w531t4/orangecrab-hardware/hardware/altcrab_r0.0.1/plot/OrangeCrab.pdf

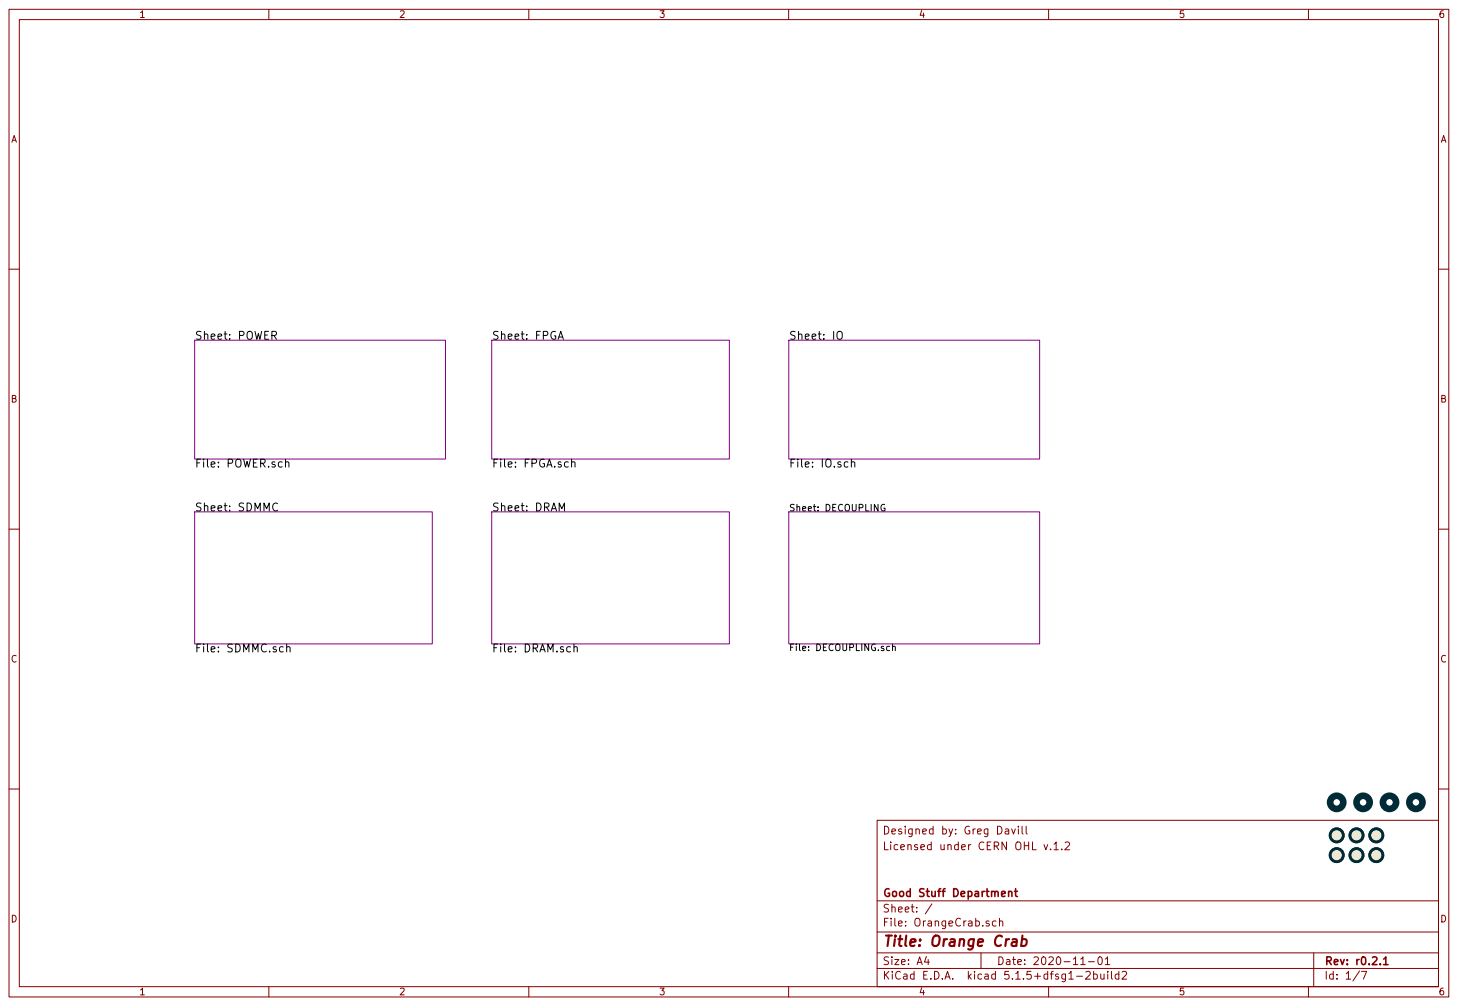
[picture p1: page 1]

File: DRAM.sch Sheet: SDMMC

File: OrangeCrab.sch Sheet: / Good Stuff Department Licensed under CERN OHL v.1.2 Designed by: Greg Davill

Id: 1/7 Title: Orange Crab

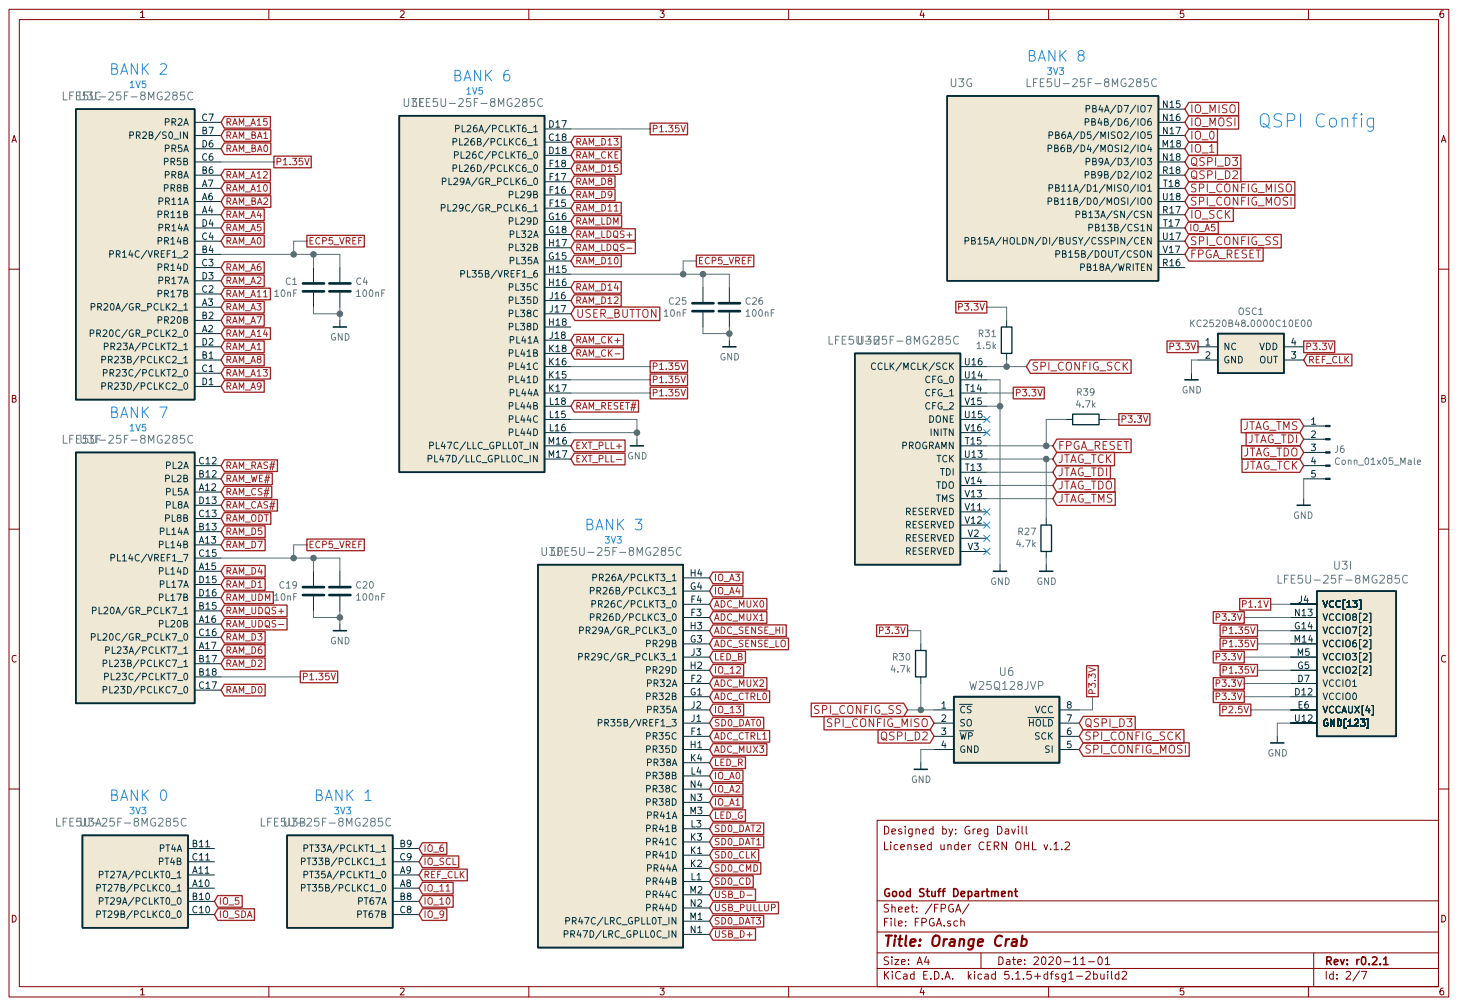
[picture p2: page 2]

Id: 2/7 Title: Orange Crab

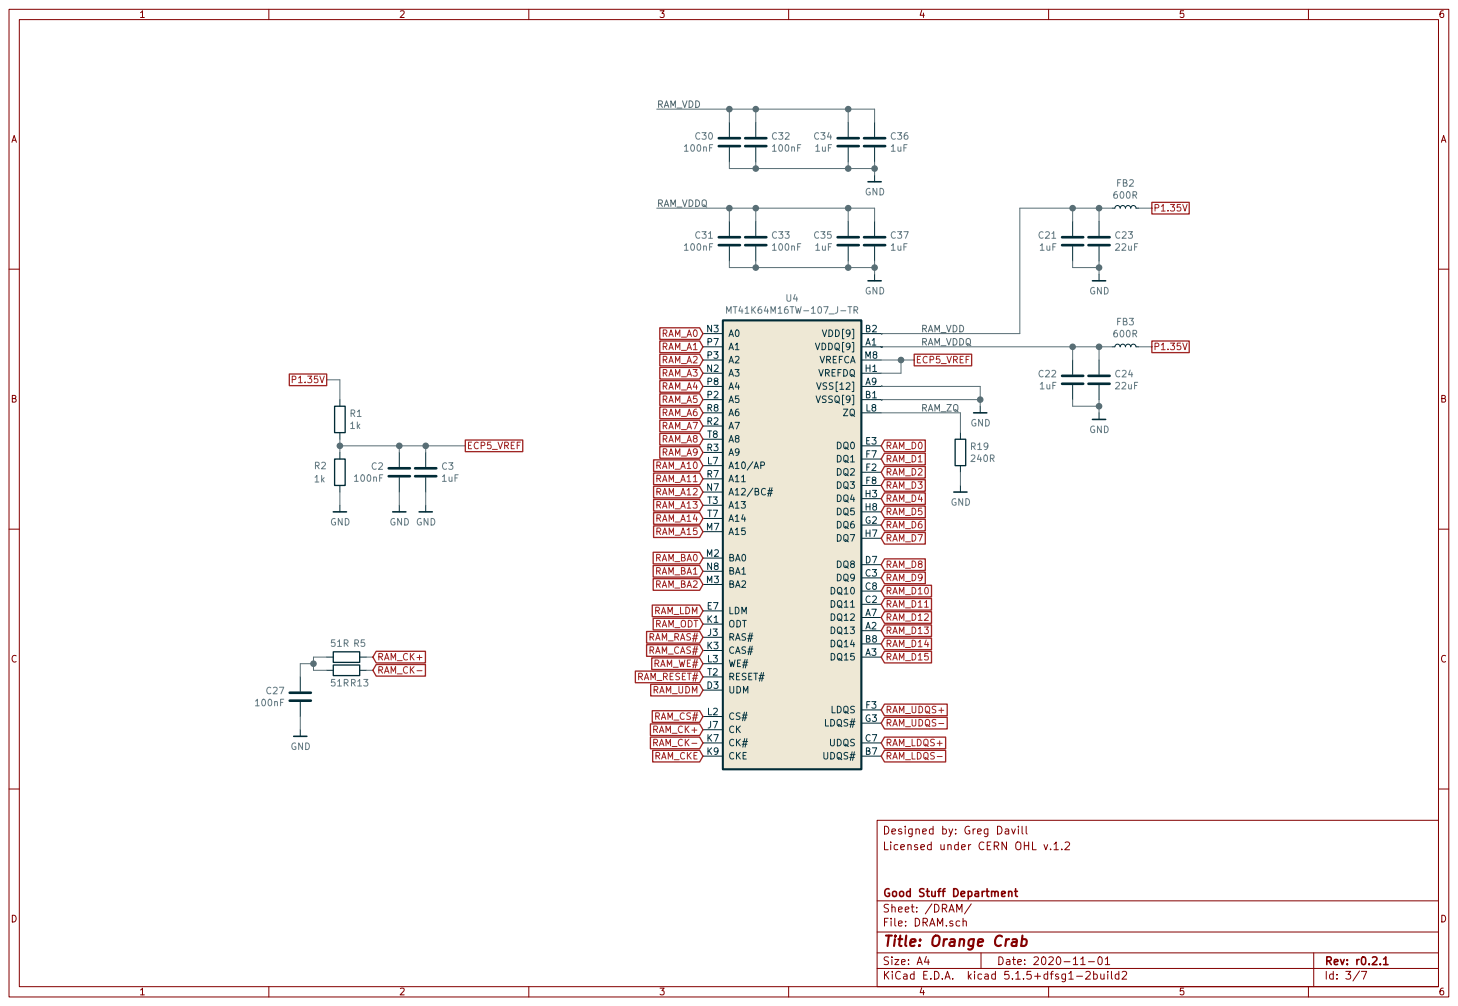
[picture p3: page 3]

RAM_VDD
1uF GND
File: DRAM.sch Sheet: /DRAM/ Good Stuff Department Licensed under CERN OHL v.1.2 Designed by: Greg Davill GND GND

Id: 3/7 Title: Orange Crab

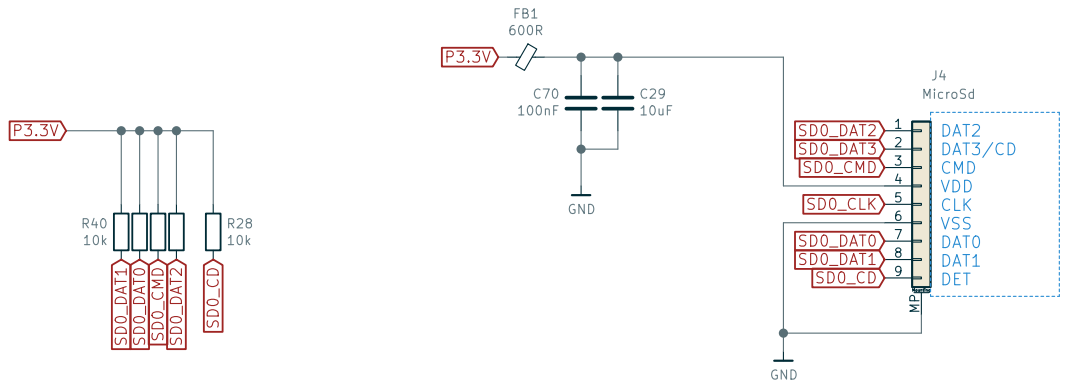
[picture p4: page 4]

File: SDMMC.sch Sheet: /SDMMC/ Good Stuff Department Licensed under CERN OHL v.1.2 Designed by: Greg Davill R40

Id: 4/7 Title: Orange Crab

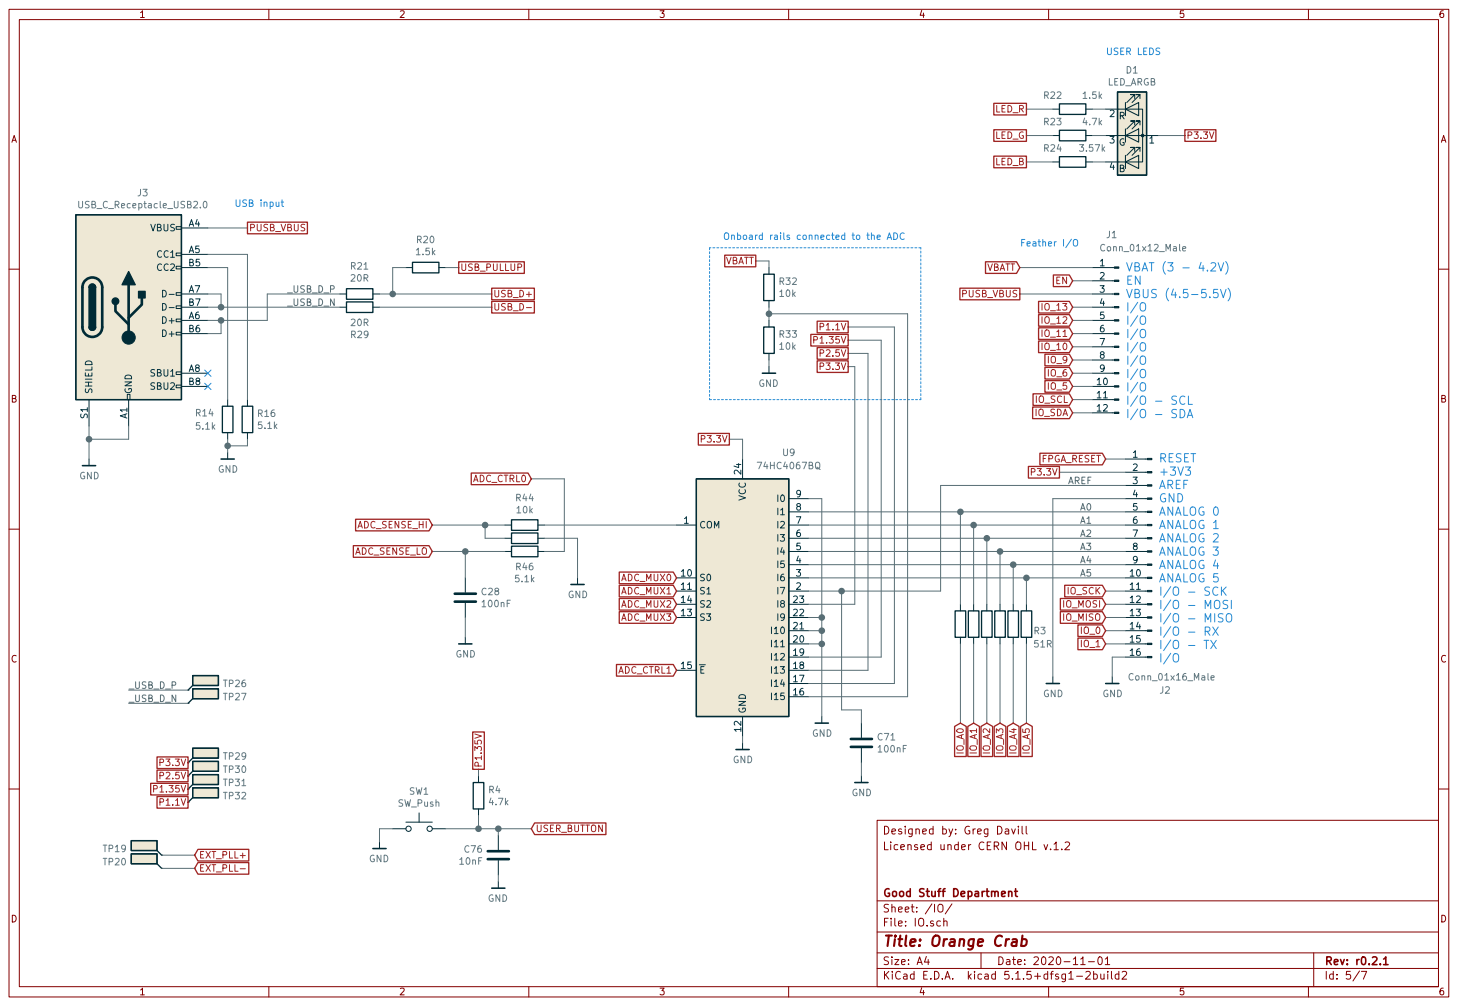
[picture p5: page 5]

Id: 5/7 Title: Orange Crab

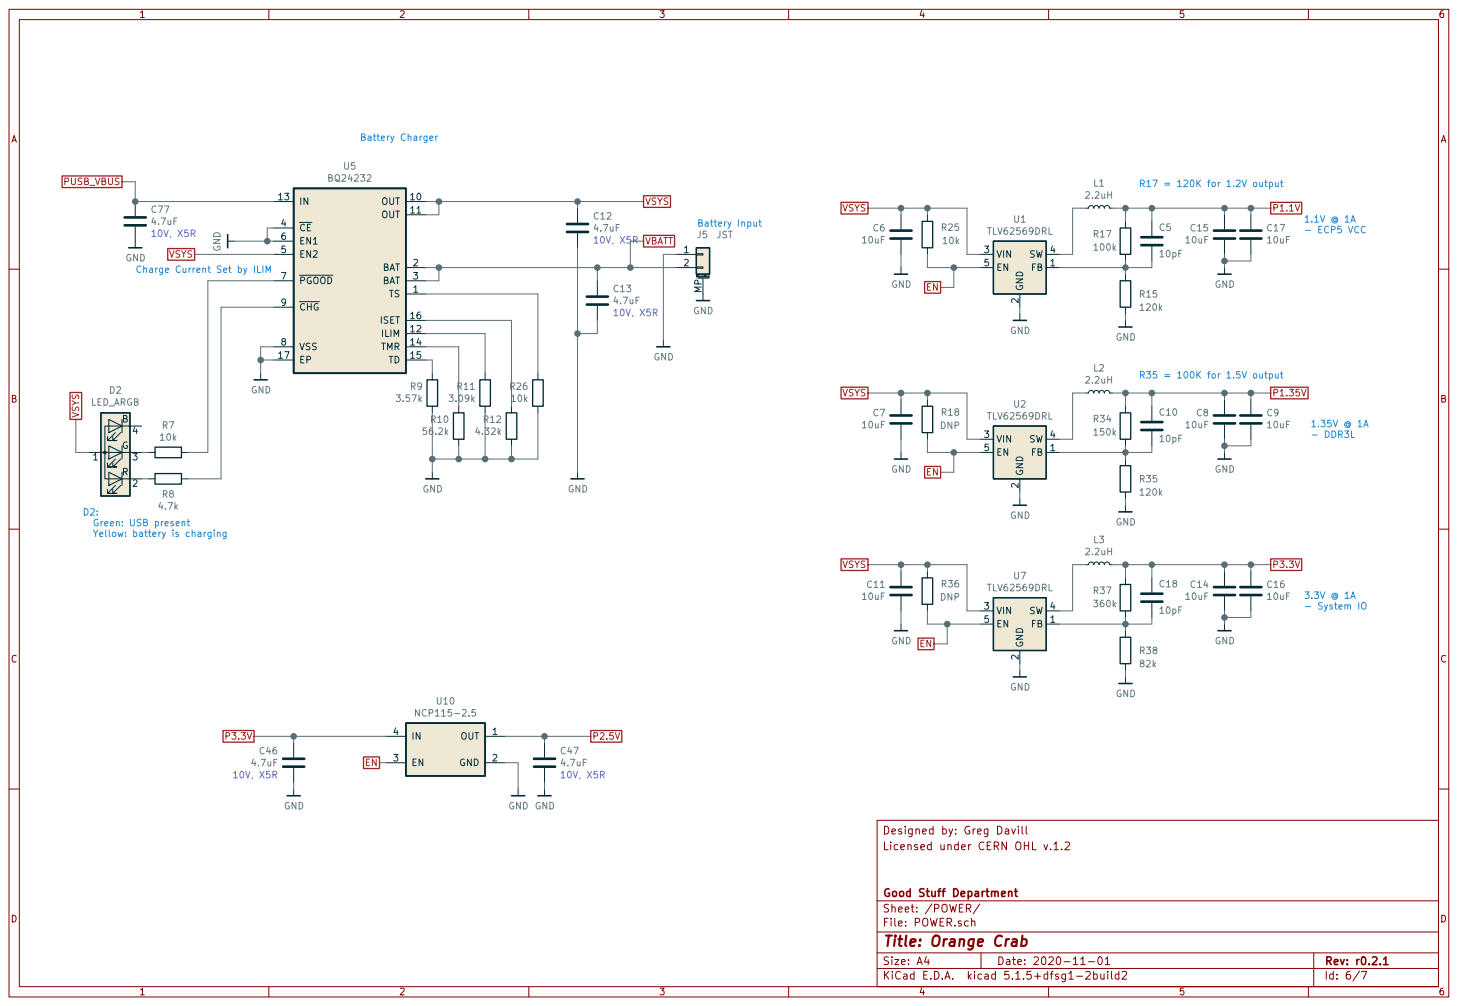
[picture p6: page 6]

2 VIN 3 SW 4 EN 5 U1 TLV62569DRL GND GND GND

2 VIN 3 SW 4 EN 5 U7 TLV62569DRL GND
Charge Current Set by ILIM

2 VIN 3 SW 4 EN 5 U2 TLV62569DRL GND GND

Green: USB present
Yellow: battery is charging

Id: 6/7 Title: Orange Crab

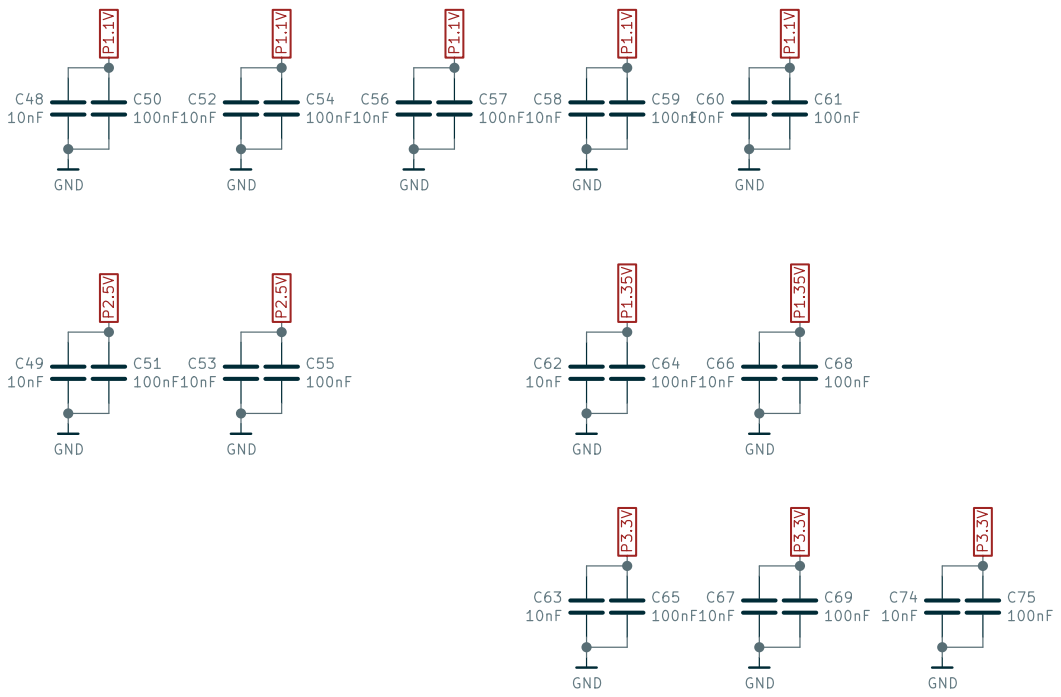
[picture p7: page 7]

File: DECOUPLING.sch Sheet: /DECOUPLING/ Good Stuff Department Licensed under CERN OHL v.1.2 Designed by: Greg Davill GND

Id: 7/7 Title: Orange Crab
