w531t4/orangecrab-hardware/hardware/altcrab_r0.0.1/OrangeCrab.kicad_pcb

## KiCad design hardware/altcrab_r0.0.1/OrangeCrab.kicad_pcb (2026-04-30)

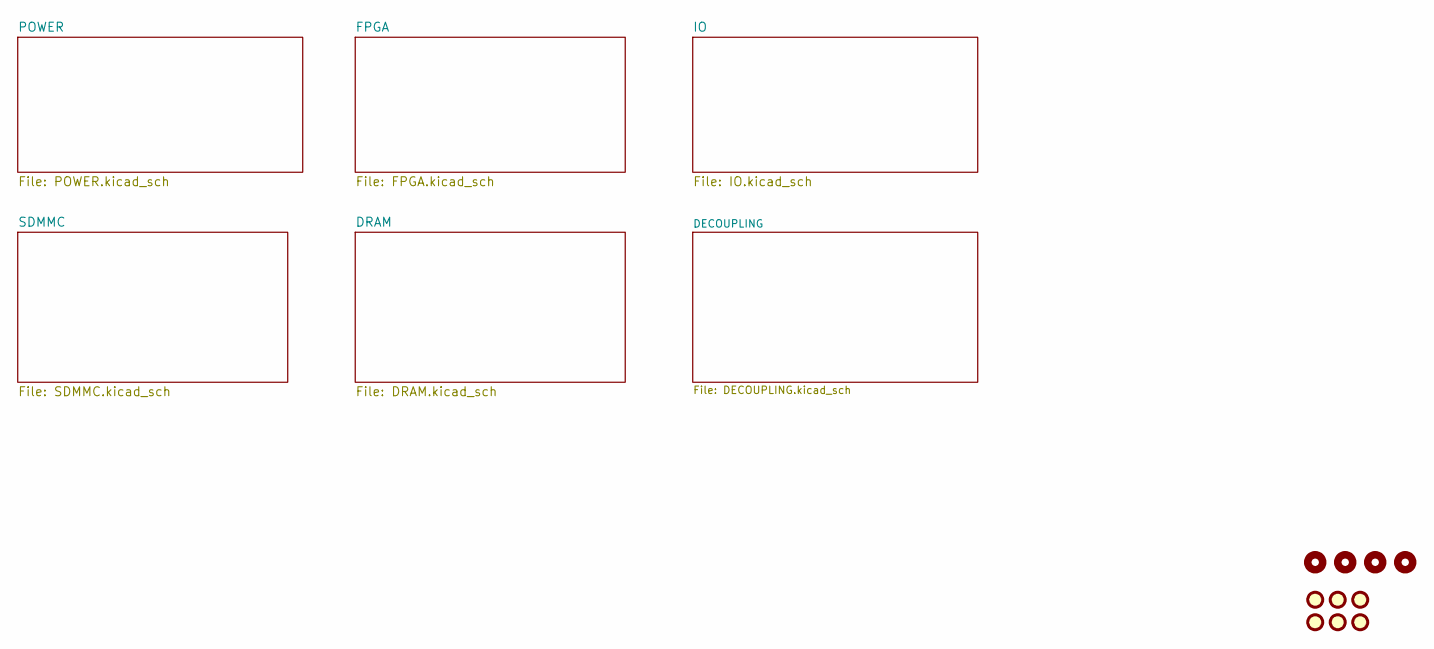
[picture p8: schematic OrangeCrab.kicad_sch, Orange Crab]

Parts:
FID1, FID2, FID3, FID4, FID5, FID6: Fiducial; Fiducial_0.75mm_Mask1.5mm
H1, H2: MountingHole; MountingHole_2.2mm_M2_Pad
H3, H4: MountingHole; MountingHole_2.1mm

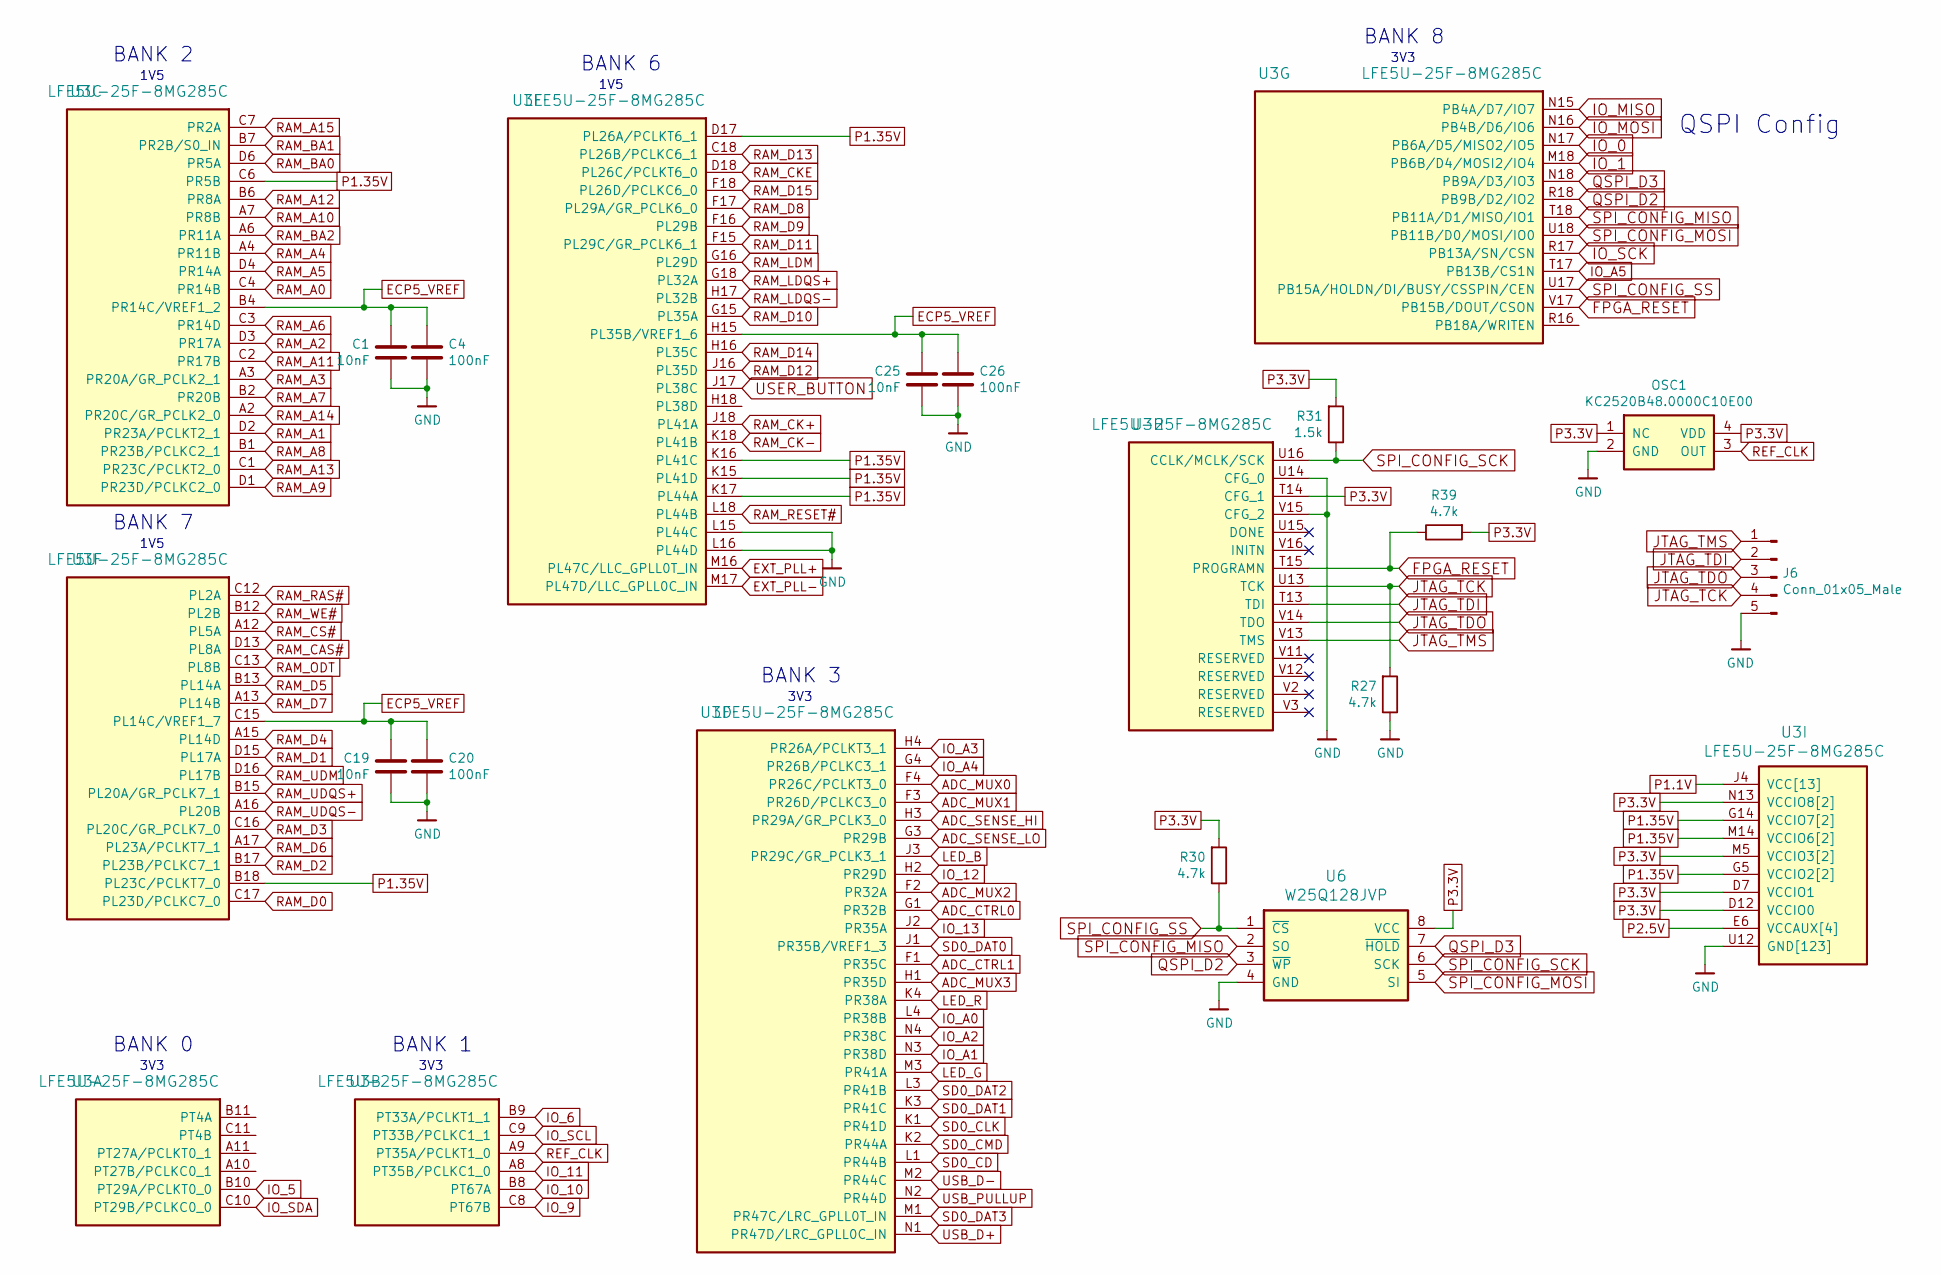
[picture p9: schematic FPGA.kicad_sch, Orange Crab]

Parts:
C1, C19, C25: 10nF; C_0201_0603Metric
C4, C20, C26: 100nF; C_0201_0603Metric
J6: Conn_01x05_Male; PinHeader_1x05_P2.54mm_Vertical
OSC1: KC2520B48.0000C10E00; Oscilator_2.5x2.0
R27, R30, R39: 4.7k; R_0201_0603Metric
R31: 1.5k; R_0201_0603Metric
U3: LFE5U-25F-8MG285C; csBGA285
U6: W25Q128JVP; WSON-8-1EP_6x5mm_P1.27mm_EP3.4x4mm

Connections:
ADC_CTRL0: U3.G1 (PR32B); also elsewhere on the board
ADC_CTRL1: U3.F1 (PR35C); also elsewhere on the board
ADC_MUX0: U3.F4 (PR26C/PCLKT3_0); also elsewhere on the board
ADC_MUX1: U3.F3 (PR26D/PCLKC3_0); also elsewhere on the board
ADC_MUX2: U3.F2 (PR32A); also elsewhere on the board
ADC_MUX3: U3.H1 (PR35D); also elsewhere on the board
ADC_SENSE_HI: U3.H3 (PR29A/GR_PCLK3_0); also elsewhere on the board
ADC_SENSE_LO: U3.G3 (PR29B); also elsewhere on the board
ECP5_VREF: C1.1, C4.1, C19.1, C20.1, C25.1, C26.1, U3.B4 (PR14C/VREF1_2), U3.C15 (PL14C/VREF1_7), U3.H15 (PL35B/VREF1_6); also elsewhere on the board
EXT_PLL+: U3.M16 (PL47C/LLC_GPLL0T_IN); also elsewhere on the board
EXT_PLL-: U3.M17 (PL47D/LLC_GPLL0C_IN); also elsewhere on the board
FPGA_RESET: R39.1, U3.T15 (PROGRAMN), U3.V17 (PB15B/DOUT/CSON); also elsewhere on the board
GND: C1.2, C4.2, C19.2, C20.2, C25.2, C26.2, J6.5, OSC1.2 (GND), R27.1, U3.B3 (GND[123]), U3.B16 (GND[123]), U3.E5 (GND[123]), U3.E7 (GND[123]), U3.E8 (GND[123]), U3.E9 (GND[123]), U3.E10 (GND[123]), U3.E11 (GND[123]), U3.E12 (GND[123]), U3.E14 (GND[123]), U3.F5 (GND[123]), U3.F6 (GND[123]), U3.F7 (GND[123]), U3.F8 (GND[123]), U3.F9 (GND[123]), U3.F10 (GND[123]), U3.F11 (GND[123]), U3.F12 (GND[123]), U3.F13 (GND[123]), U3.F14 (GND[123]), U3.G2 (GND[123]), U3.G6 (GND[123]), U3.G7 (GND[123]), U3.G8 (GND[123]), U3.G9 (GND[123]), U3.G10 (GND[123]), U3.G11 (GND[123]), U3.G12 (GND[123]), U3.G13 (GND[123]), U3.G17 (GND[123]), U3.H6 (GND[123]), U3.H7 (GND[123]), U3.H8 (GND[123]), U3.H9 (GND[123]), U3.H10 (GND[123]), U3.H11 (GND[123]), U3.H12 (GND[123]), U3.H13 (GND[123]), U3.J6 (GND[123]), U3.J7 (GND[123]), U3.J8 (GND[123]), U3.J9 (GND[123]), U3.J10 (GND[123]), U3.J11 (GND[123]), U3.J12 (GND[123]), U3.J13 (GND[123]), U3.K5 (GND[123]), U3.K6 (GND[123]), U3.K7 (GND[123]), U3.K8 (GND[123]), U3.K9 (GND[123]), U3.K10 (GND[123]), U3.K11 (GND[123]), U3.K12 (GND[123]), U3.K13 (GND[123]), U3.K14 (GND[123]), U3.L2 (GND[123]), U3.L5 (GND[123]), U3.L6 (GND[123]), U3.L7 (GND[123]), U3.L8 (GND[123]), U3.L9 (GND[123]), U3.L10 (GND[123]), U3.L11 (GND[123]), U3.L12 (GND[123]), U3.L13 (GND[123]), U3.L14 (GND[123]), U3.L15 (PL44C), U3.L16 (PL44D), U3.L17 (GND[123]), U3.M6 (GND[123]), U3.M7 (GND[123]), U3.M8 (GND[123]), U3.M9 (GND[123]), U3.M10 (GND[123]), U3.M11 (GND[123]), U3.M12 (GND[123]), U3.M13 (GND[123]), U3.N7 (GND[123]), U3.N8 (GND[123]), U3.N9 (GND[123]), U3.N10 (GND[123]), U3.N11 (GND[123]), U3.N12 (GND[123]), U3.P5 (GND[123]), U3.P6 (GND[123]), U3.P8 (GND[123]), U3.P10 (GND[123]), U3.P12 (GND[123]), U3.R1 (GND[123]), U3.R2 (GND[123]), U3.R3 (GND[123]), U3.R10 (GND[123]), U3.T1 (GND[123]), U3.T2 (GND[123]), U3.T3 (GND[123]), U3.T4 (GND[123]), U3.T5 (GND[123]), U3.T6 (GND[123]), U3.T7 (GND[123]), U3.T8 (GND[123]), U3.T9 (GND[123]), U3.T10 (GND[123]), U3.T11 (GND[123]), U3.T12 (GND[123]), U3.T16 (GND[123]), U3.U1 (GND[123]), U3.U2 (GND[123]), U3.U3 (GND[123]), U3.U4 (GND[123]), U3.U5 (GND[123]), U3.U6 (GND[123]), U3.U7 (GND[123]), U3.U8 (GND[123]), U3.U9 (GND[123]), U3.U10 (GND[123]), U3.U11 (GND[123]), U3.U12 (GND[123]), U3.U14 (CFG_0), U3.V4 (GND[123]), U3.V5 (GND[123]), U3.V6 (GND[123]), U3.V7 (GND[123]), U3.V8 (GND[123]), U3.V9 (GND[123]), U3.V10 (GND[123]), U3.V15 (CFG_2), U6.4 (GND); also elsewhere on the board
IO_0: U3.N17 (PB6A/D5/MISO2/IO5); also elsewhere on the board
IO_1: U3.M18 (PB6B/D4/MOSI2/IO4); also elsewhere on the board
IO_5: U3.B10 (PT29A/PCLKT0_0); also elsewhere on the board
IO_6: U3.B9 (PT33A/PCLKT1_1); also elsewhere on the board
IO_9: U3.C8 (PT67B); also elsewhere on the board
IO_10: U3.B8 (PT67A); also elsewhere on the board
IO_11: U3.A8 (PT35B/PCLKC1_0); also elsewhere on the board
IO_12: U3.H2 (PR29D); also elsewhere on the board
IO_13: U3.J2 (PR35A); also elsewhere on the board
IO_A0: U3.L4 (PR38B); also elsewhere on the board
IO_A1: U3.N3 (PR38D); also elsewhere on the board
IO_A2: U3.N4 (PR38C); also elsewhere on the board
IO_A3: U3.H4 (PR26A/PCLKT3_1); also elsewhere on the board
IO_A4: U3.G4 (PR26B/PCLKC3_1); also elsewhere on the board
IO_A5: U3.T17 (PB13B/CS1N); also elsewhere on the board
IO_MISO: U3.N15 (PB4A/D7/IO7); also elsewhere on the board
IO_MOSI: U3.N16 (PB4B/D6/IO6); also elsewhere on the board
IO_SCK: U3.R17 (PB13A/SN/CSN); also elsewhere on the board
IO_SCL: U3.C9 (PT33B/PCLKC1_1); also elsewhere on the board
IO_SDA: U3.C10 (PT29B/PCLKC0_0); also elsewhere on the board
JTAG_TCK: J6.4, R27.2, U3.U13 (TCK)
JTAG_TDI: J6.2, U3.T13 (TDI)
JTAG_TDO: J6.3, U3.V14 (TDO)
JTAG_TMS: J6.1, U3.V13 (TMS)
LED_B: U3.J3 (PR29C/GR_PCLK3_1); also elsewhere on the board
LED_G: U3.M3 (PR41A); also elsewhere on the board
LED_R: U3.K4 (PR38A); also elsewhere on the board
P1.1V: U3.D8 (VCC[13]), U3.D9 (VCC[13]), U3.D10 (VCC[13]), U3.D11 (VCC[13]), U3.J4 (VCC[13]), U3.J5 (VCC[13]), U3.J14 (VCC[13]), U3.J15 (VCC[13]), U3.M4 (VCC[13]), U3.M15 (VCC[13]), U3.P7 (VCC[13]), U3.P9 (VCC[13]), U3.P11 (VCC[13]); also elsewhere on the board
P1.35V: U3.B18 (PL23C/PCLKT7_0), U3.C6 (PR5B), U3.D17 (PL26A/PCLKT6_1), U3.G5 (VCCIO2[2]), U3.G14 (VCCIO7[2]), U3.H5 (VCCIO2[2]), U3.H14 (VCCIO7[2]), U3.K15 (PL41D), U3.K16 (PL41C), U3.K17 (PL44A), U3.M14 (VCCIO6[2]), U3.N14 (VCCIO6[2]); also elsewhere on the board
P2.5V: U3.E6 (VCCAUX[4]), U3.E13 (VCCAUX[4]), U3.N6 (VCCAUX[4]), U3.P13 (VCCAUX[4]); also elsewhere on the board
P3.3V: OSC1.1 (NC), OSC1.4 (VDD), R30.2, R31.2, R39.2, U3.D7 (VCCIO1), U3.D12 (VCCIO0), U3.M5 (VCCIO3[2]), U3.N5 (VCCIO3[2]), U3.N13 (VCCIO8[2]), U3.P14 (VCCIO8[2]), U3.T14 (CFG_1), U6.8 (VCC); also elsewhere on the board
QSPI_D2: U3.R18 (PB9B/D2/IO2), U6.3 (~WP)
QSPI_D3: U3.N18 (PB9A/D3/IO3), U6.7 (~HOLD)
RAM_A0: U3.C4 (PR14B); also elsewhere on the board
RAM_A1: U3.D2 (PR23A/PCLKT2_1); also elsewhere on the board
RAM_A2: U3.D3 (PR17A); also elsewhere on the board
RAM_A3: U3.A3 (PR20A/GR_PCLK2_1); also elsewhere on the board
RAM_A4: U3.A4 (PR11B); also elsewhere on the board
RAM_A5: U3.D4 (PR14A); also elsewhere on the board
RAM_A6: U3.C3 (PR14D); also elsewhere on the board
RAM_A7: U3.B2 (PR20B); also elsewhere on the board
RAM_A8: U3.B1 (PR23B/PCLKC2_1); also elsewhere on the board
RAM_A9: U3.D1 (PR23D/PCLKC2_0); also elsewhere on the board
RAM_A10: U3.A7 (PR8B); also elsewhere on the board
RAM_A11: U3.C2 (PR17B); also elsewhere on the board
RAM_A12: U3.B6 (PR8A); also elsewhere on the board
RAM_A13: U3.C1 (PR23C/PCLKT2_0); also elsewhere on the board
RAM_A14: U3.A2 (PR20C/GR_PCLK2_0); also elsewhere on the board
RAM_A15: U3.C7 (PR2A); also elsewhere on the board
RAM_BA0: U3.D6 (PR5A); also elsewhere on the board
RAM_BA1: U3.B7 (PR2B/S0_IN); also elsewhere on the board
RAM_BA2: U3.A6 (PR11A); also elsewhere on the board
RAM_CAS#: U3.D13 (PL8A); also elsewhere on the board
RAM_CK+: U3.J18 (PL41A); also elsewhere on the board
RAM_CK-: U3.K18 (PL41B); also elsewhere on the board
RAM_CKE: U3.D18 (PL26C/PCLKT6_0); also elsewhere on the board
RAM_CS#: U3.A12 (PL5A); also elsewhere on the board
RAM_D0: U3.C17 (PL23D/PCLKC7_0); also elsewhere on the board
RAM_D1: U3.D15 (PL17A); also elsewhere on the board
RAM_D2: U3.B17 (PL23B/PCLKC7_1); also elsewhere on the board
RAM_D3: U3.C16 (PL20C/GR_PCLK7_0); also elsewhere on the board
RAM_D4: U3.A15 (PL14D); also elsewhere on the board
RAM_D5: U3.B13 (PL14A); also elsewhere on the board
RAM_D6: U3.A17 (PL23A/PCLKT7_1); also elsewhere on the board
RAM_D7: U3.A13 (PL14B); also elsewhere on the board
RAM_D8: U3.F17 (PL29A/GR_PCLK6_0); also elsewhere on the board
RAM_D9: U3.F16 (PL29B); also elsewhere on the board
RAM_D10: U3.G15 (PL35A); also elsewhere on the board
RAM_D11: U3.F15 (PL29C/GR_PCLK6_1); also elsewhere on the board
RAM_D12: U3.J16 (PL35D); also elsewhere on the board
RAM_D13: U3.C18 (PL26B/PCLKC6_1); also elsewhere on the board
RAM_D14: U3.H16 (PL35C); also elsewhere on the board
RAM_D15: U3.F18 (PL26D/PCLKC6_0); also elsewhere on the board
RAM_LDM: U3.G16 (PL29D); also elsewhere on the board
RAM_LDQS+: U3.G18 (PL32A); also elsewhere on the board
RAM_LDQS-: U3.H17 (PL32B); also elsewhere on the board
RAM_ODT: U3.C13 (PL8B); also elsewhere on the board
RAM_RAS#: U3.C12 (PL2A); also elsewhere on the board
RAM_RESET#: U3.L18 (PL44B); also elsewhere on the board
RAM_UDM: U3.D16 (PL17B); also elsewhere on the board
RAM_UDQS+: U3.B15 (PL20A/GR_PCLK7_1); also elsewhere on the board
RAM_UDQS-: U3.A16 (PL20B); also elsewhere on the board
RAM_WE#: U3.B12 (PL2B); also elsewhere on the board
REF_CLK: OSC1.3 (OUT), U3.A9 (PT35A/PCLKT1_0)
SD0_CD: U3.L1 (PR44B); also elsewhere on the board
SD0_CLK: U3.K1 (PR41D); also elsewhere on the board
SD0_CMD: U3.K2 (PR44A); also elsewhere on the board
SD0_DAT0: U3.J1 (PR35B/VREF1_3); also elsewhere on the board
SD0_DAT1: U3.K3 (PR41C); also elsewhere on the board
SD0_DAT2: U3.L3 (PR41B); also elsewhere on the board
SD0_DAT3: U3.M1 (PR47C/LRC_GPLL0T_IN); also elsewhere on the board
SPI_CONFIG_MISO: U3.T18 (PB11A/D1/MISO/IO1), U6.2 (SO)
SPI_CONFIG_MOSI: U3.U18 (PB11B/D0/MOSI/IO0), U6.5 (SI)
SPI_CONFIG_SCK: R31.1, U3.U16 (CCLK/MCLK/SCK), U6.6 (SCK)
SPI_CONFIG_SS: R30.1, U3.U17 (PB15A/HOLDN/DI/BUSY/CSSPIN/CEN), U6.1 (~CS)
USB_D+: U3.N1 (PR47D/LRC_GPLL0C_IN); also elsewhere on the board
USB_D-: U3.M2 (PR44C); also elsewhere on the board
USB_PULLUP: U3.N2 (PR44D); also elsewhere on the board
USER_BUTTON: U3.J17 (PL38C); also elsewhere on the board

Notes on the sheet:
BANK 8
QSPI Config
3V3
BANK 3
1V5
BANK 2
3V3
BANK 6
BANK 7
BANK 0
1V5
BANK 1

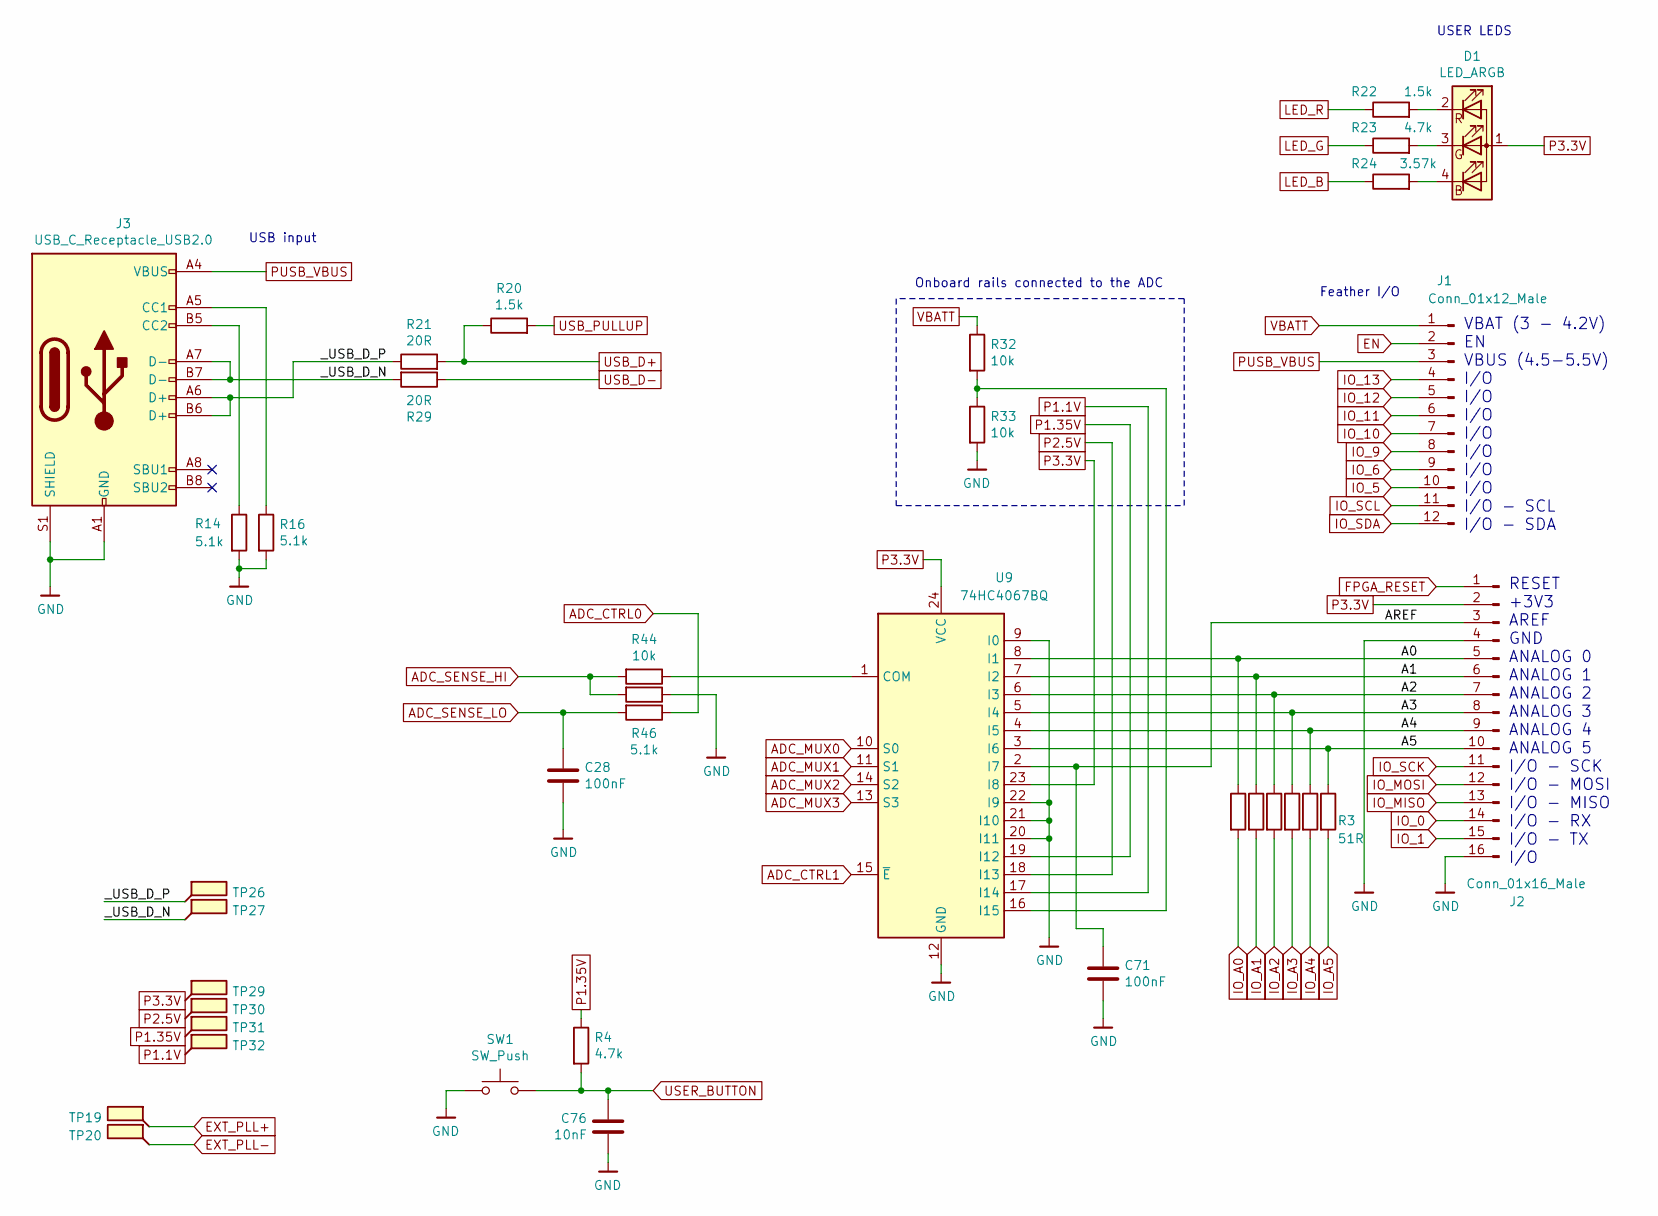
[picture p10: schematic IO.kicad_sch, Orange Crab]

Parts:
C28, C71: 100nF; C_0201_0603Metric
C76: 10nF; C_0201_0603Metric
D1: LED_ARGB; 0404LED_RGB
J1: Conn_01x12_Male; Feather_PinHeader_1x12 _ castellated
J2: Conn_01x16_Male; Feather_PinHeader_1x16_castellated
J3: USB_C_Receptacle_USB2.0; USB_C_Receptacle_HRO_TYPE-C-31-M-12
R3, R6, R48, R49, R50, R51: 51R; R_0201_0603Metric
R4, R23: 4.7k; R_0201_0603Metric
R14, R16, R46: 5.1k; R_0201_0603Metric
R20, R22: 1.5k; R_0201_0603Metric
R21, R29: 20R; R_0201_0603Metric
R24: 3.57k; R_0201_0603Metric
R32, R33, R44, R45: 10k; R_0201_0603Metric
SW1: SW_Push; PTS_810_SMT_Switch
TP19, TP20, TP26, TP27, TP29, TP30, TP31, TP32: SMD_TP; TestPoint_Pad_D0.5mm
U9: 74HC4067BQ; Texas_RGY_R-PVQFN-N24_EP2.05x3.1mm

Connections:
/IO/A0: J2.5, R48.1, U9.8 (I1)
/IO/A1: J2.6, R49.1, U9.7 (I2)
/IO/A2: J2.7, R50.1, U9.6 (I3)
/IO/A3: J2.8, R51.1, U9.5 (I4)
/IO/A4: J2.9, R6.1, U9.4 (I5)
/IO/A5: J2.10, R3.1, U9.3 (I6)
/IO/AREF: C71.1, J2.3, U9.2 (I7)
/IO/_USB_D_N: J3.A7 (D-), J3.B7 (D-), R29.2, TP27.1
/IO/_USB_D_P: J3.A6 (D+), J3.B6 (D+), R21.1, TP26.1
ADC_CTRL0: R46.1; also elsewhere on the board
ADC_CTRL1: U9.15 (~E); also elsewhere on the board
ADC_MUX0: U9.10 (S0); also elsewhere on the board
ADC_MUX1: U9.11 (S1); also elsewhere on the board
ADC_MUX2: U9.14 (S2); also elsewhere on the board
ADC_MUX3: U9.13 (S3); also elsewhere on the board
ADC_SENSE_HI: R44.2, R45.2; also elsewhere on the board
ADC_SENSE_LO: C28.1, R46.2; also elsewhere on the board
EN: J1.2; also elsewhere on the board
EXT_PLL+: TP19.1; also elsewhere on the board
EXT_PLL-: TP20.1; also elsewhere on the board
FPGA_RESET: J2.1; also elsewhere on the board
GND: C28.2, C71.2, C76.2, J2.4, J2.16, J3.A1 (GND), J3.A12 (GND), J3.B1 (GND), J3.B12 (GND), J3.S1 (SHIELD), R14.2, R16.2, R33.2, R45.1, SW1.1, U9.9 (I0), U9.12 (GND), U9.20 (I11), U9.21 (I10), U9.22 (I9); also elsewhere on the board
IO_0: J2.14; also elsewhere on the board
IO_1: J2.15; also elsewhere on the board
IO_5: J1.10; also elsewhere on the board
IO_6: J1.9; also elsewhere on the board
IO_9: J1.8; also elsewhere on the board
IO_10: J1.7; also elsewhere on the board
IO_11: J1.6; also elsewhere on the board
IO_12: J1.5; also elsewhere on the board
IO_13: J1.4; also elsewhere on the board
IO_A0: R48.2; also elsewhere on the board
IO_A1: R49.2; also elsewhere on the board
IO_A2: R50.2; also elsewhere on the board
IO_A3: R51.2; also elsewhere on the board
IO_A4: R6.2; also elsewhere on the board
IO_A5: R3.2; also elsewhere on the board
IO_MISO: J2.13; also elsewhere on the board
IO_MOSI: J2.12; also elsewhere on the board
IO_SCK: J2.11; also elsewhere on the board
IO_SCL: J1.11; also elsewhere on the board
IO_SDA: J1.12; also elsewhere on the board
LED_B: R24.1; also elsewhere on the board
LED_G: R23.1; also elsewhere on the board
LED_R: R22.1; also elsewhere on the board
unnamed: D1.4 (BK), R24.2
unnamed: D1.3 (GK), R23.2
unnamed: D1.2 (RK), R22.2
unnamed: J3.A5 (CC1), R16.1
unnamed: J3.B5 (CC2), R14.1
unnamed: R44.1, U9.1 (COM)
unnamed: R32.2, R33.1, U9.16 (I15)
P1.1V: TP32.1, U9.17 (I14); also elsewhere on the board
P1.35V: R4.1, TP31.1, U9.19 (I12); also elsewhere on the board
P2.5V: TP30.1, U9.18 (I13); also elsewhere on the board
P3.3V: D1.1 (A), J2.2, TP29.1, U9.23 (I8), U9.24 (VCC); also elsewhere on the board
PUSB_VBUS: J1.3, J3.A4 (VBUS), J3.A9 (VBUS), J3.B4 (VBUS), J3.B9 (VBUS); also elsewhere on the board
USB_D+: R20.1, R21.2; also elsewhere on the board
USB_D-: R29.1; also elsewhere on the board
USB_PULLUP: R20.2; also elsewhere on the board
USER_BUTTON: C76.1, R4.2, SW1.2; also elsewhere on the board
VBATT: J1.1, R32.1; also elsewhere on the board

Notes on the sheet:
VBAT (3 - 4.2V) EN VBUS (4.5-5.5V) I/O I/O I/O I/O I/O I/O I/O I/O - SCL I/O - SDA
Onboard rails connected to the ADC
Feather I/O
USER LEDS
USB input
RESET +3V3 AREF GND ANALOG 0 ANALOG 1 ANALOG 2 ANALOG 3 ANALOG 4 ANALOG 5 I/O - SCK I/O - MOSI I/O - MISO I/O - RX I/O - TX I/O

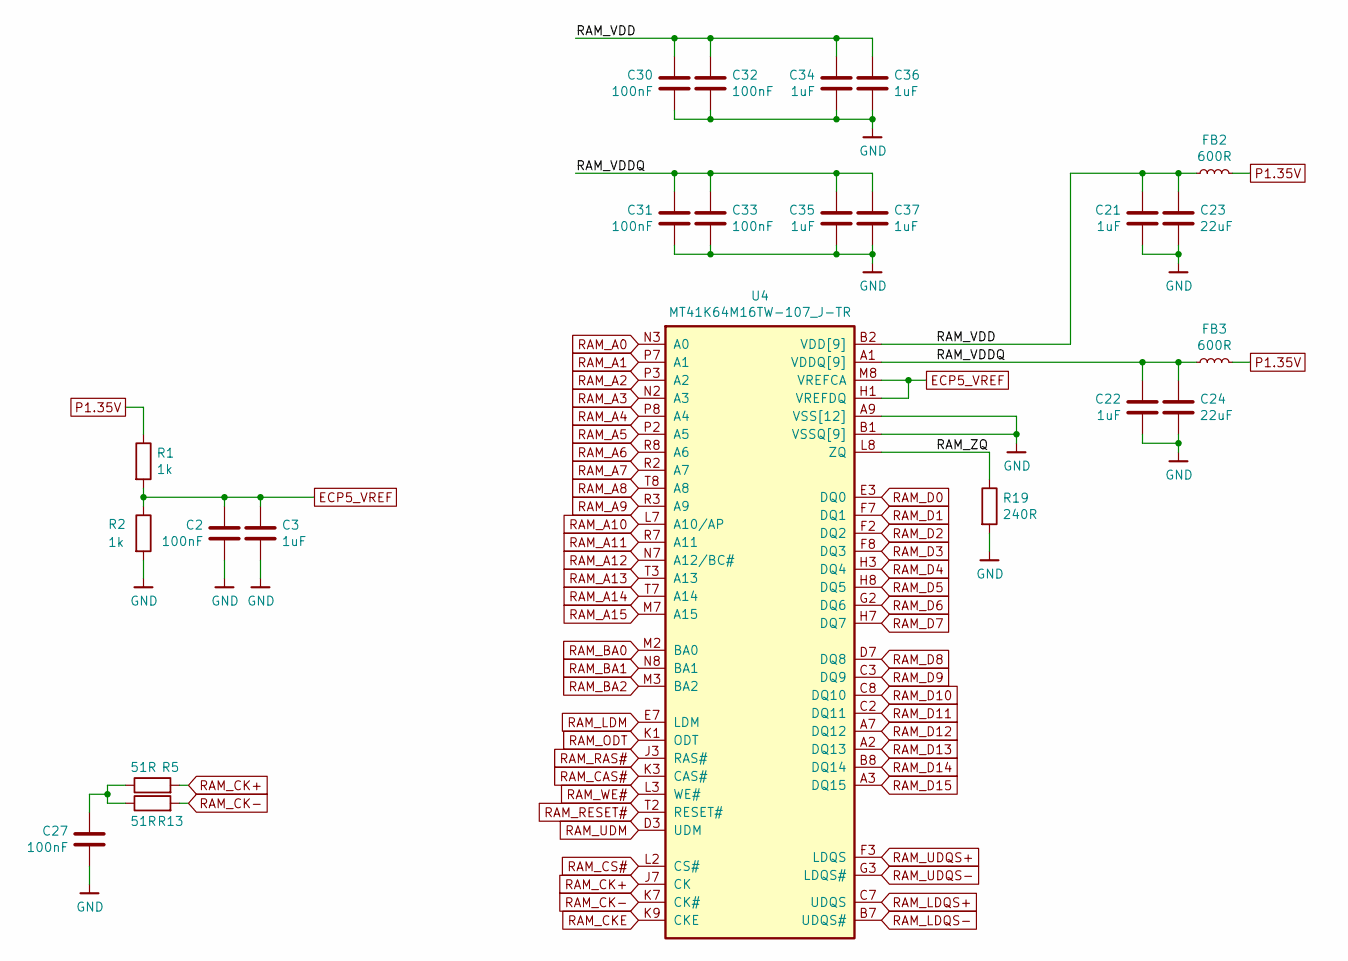
[picture p11: schematic DRAM.kicad_sch, Orange Crab]

Parts:
C2, C27, C30, C31, C32, C33: 100nF; C_0201_0603Metric
C3, C21, C22, C34, C35, C36, C37: 1uF; C_0402_1005Metric
C23, C24: 22uF; C_0603_1608Metric
FB2, FB3: 600R; L_0402_1005Metric
R1, R2: 1k; R_0201_0603Metric
R5, R13: 51R; R_0201_0603Metric
R19: 240R; R_0402_1005Metric
U4: MT41K64M16TW-107_J-TR; BGA-96_9.0x13.0mm_Layout2x3x16_P0.8mm

Connections:
/DRAM/RAM_VDD: C21.1, C23.1, C30.1, C32.1, C34.1, C36.1, FB2.1, U4.B2 (VDD[9]), U4.D9 (VDD), U4.G7 (VDD), U4.K2 (VDD), U4.K8 (VDD), U4.N1 (VDD), U4.N9 (VDD), U4.R1 (VDD), U4.R9 (VDD)
/DRAM/RAM_VDDQ: C22.1, C24.1, C31.1, C33.1, C35.1, C37.1, FB3.1, U4.A1 (VDDQ[9]), U4.A8 (VDDQ), U4.C1 (VDDQ), U4.C9 (VDDQ), U4.D2 (VDDQ), U4.E9 (VDDQ), U4.F1 (VDDQ), U4.H2 (VDDQ), U4.H9 (VDDQ)
/DRAM/RAM_ZQ: R19.1, U4.L8 (ZQ)
ECP5_VREF: C2.1, C3.1, R1.2, R2.1, U4.H1 (VREFDQ), U4.M8 (VREFCA); also elsewhere on the board
GND: C2.2, C3.2, C21.2, C22.2, C23.2, C24.2, C27.2, C30.2, C31.2, C32.2, C33.2, C34.2, C35.2, C36.2, C37.2, R2.2, R19.2, U4.A9 (VSS[12]), U4.B1 (VSSQ[9]), U4.B3 (VSS), U4.B9 (VSSQ), U4.D1 (VSSQ), U4.D8 (VSSQ), U4.E1 (VSS), U4.E2 (VSSQ), U4.E8 (VSSQ), U4.F9 (VSSQ), U4.G1 (VSSQ), U4.G9 (VSSQ), U4.J2 (VSS), U4.J8 (VSS), U4.M1 (VSS), U4.M9 (VSS), U4.P1 (VSS), U4.P9 (VSS), U4.T1 (VSS), U4.T9 (VSS); also elsewhere on the board
unnamed: C27.1, R5.1, R13.1
P1.35V: FB2.2, FB3.2, R1.1; also elsewhere on the board
RAM_A0: U4.N3 (A0); also elsewhere on the board
RAM_A1: U4.P7 (A1); also elsewhere on the board
RAM_A2: U4.P3 (A2); also elsewhere on the board
RAM_A3: U4.N2 (A3); also elsewhere on the board
RAM_A4: U4.P8 (A4); also elsewhere on the board
RAM_A5: U4.P2 (A5); also elsewhere on the board
RAM_A6: U4.R8 (A6); also elsewhere on the board
RAM_A7: U4.R2 (A7); also elsewhere on the board
RAM_A8: U4.T8 (A8); also elsewhere on the board
RAM_A9: U4.R3 (A9); also elsewhere on the board
RAM_A10: U4.L7 (A10/AP); also elsewhere on the board
RAM_A11: U4.R7 (A11); also elsewhere on the board
RAM_A12: U4.N7 (A12/BC#); also elsewhere on the board
RAM_A13: U4.T3 (A13); also elsewhere on the board
RAM_A14: U4.T7 (A14); also elsewhere on the board
RAM_A15: U4.M7 (A15); also elsewhere on the board
RAM_BA0: U4.M2 (BA0); also elsewhere on the board
RAM_BA1: U4.N8 (BA1); also elsewhere on the board
RAM_BA2: U4.M3 (BA2); also elsewhere on the board
RAM_CAS#: U4.K3 (CAS#); also elsewhere on the board
RAM_CK+: R5.2, U4.J7 (CK); also elsewhere on the board
RAM_CK-: R13.2, U4.K7 (CK#); also elsewhere on the board
RAM_CKE: U4.K9 (CKE); also elsewhere on the board
RAM_CS#: U4.L2 (CS#); also elsewhere on the board
RAM_D0: U4.E3 (DQ0); also elsewhere on the board
RAM_D1: U4.F7 (DQ1); also elsewhere on the board
RAM_D2: U4.F2 (DQ2); also elsewhere on the board
RAM_D3: U4.F8 (DQ3); also elsewhere on the board
RAM_D4: U4.H3 (DQ4); also elsewhere on the board
RAM_D5: U4.H8 (DQ5); also elsewhere on the board
RAM_D6: U4.G2 (DQ6); also elsewhere on the board
RAM_D7: U4.H7 (DQ7); also elsewhere on the board
RAM_D8: U4.D7 (DQ8); also elsewhere on the board
RAM_D9: U4.C3 (DQ9); also elsewhere on the board
RAM_D10: U4.C8 (DQ10); also elsewhere on the board
RAM_D11: U4.C2 (DQ11); also elsewhere on the board
RAM_D12: U4.A7 (DQ12); also elsewhere on the board
RAM_D13: U4.A2 (DQ13); also elsewhere on the board
RAM_D14: U4.B8 (DQ14); also elsewhere on the board
RAM_D15: U4.A3 (DQ15); also elsewhere on the board
RAM_LDM: U4.E7 (LDM); also elsewhere on the board
RAM_LDQS+: U4.C7 (UDQS); also elsewhere on the board
RAM_LDQS-: U4.B7 (UDQS#); also elsewhere on the board
RAM_ODT: U4.K1 (ODT); also elsewhere on the board
RAM_RAS#: U4.J3 (RAS#); also elsewhere on the board
RAM_RESET#: U4.T2 (RESET#); also elsewhere on the board
RAM_UDM: U4.D3 (UDM); also elsewhere on the board
RAM_UDQS+: U4.F3 (LDQS); also elsewhere on the board
RAM_UDQS-: U4.G3 (LDQS#); also elsewhere on the board
RAM_WE#: U4.L3 (WE#); also elsewhere on the board

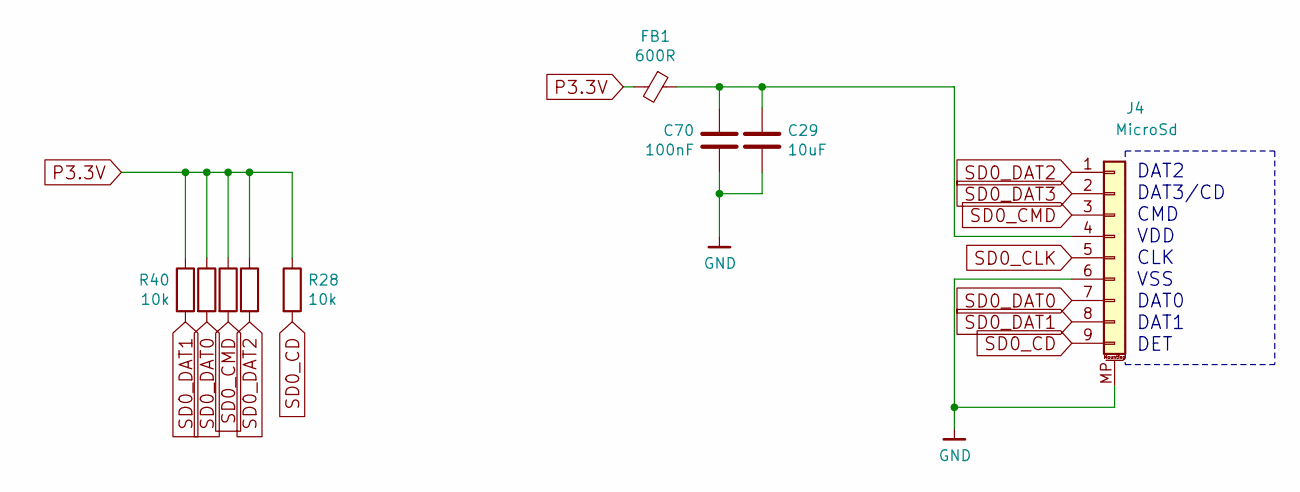
[picture p12: schematic SDMMC.kicad_sch, Orange Crab]

Parts:
C29: 10uF; C_0402_1005Metric
C70: 100nF; C_0201_0603Metric
FB1: 600R; L_0402_1005Metric
J4: MicroSd; molex_microsd_1040310811
R28, R40, R41, R42, R43: 10k; R_0201_0603Metric

Connections:
GND: C29.1, C70.1, J4.6, J4.MP (MountPin); also elsewhere on the board
unnamed: C29.2, C70.2, FB1.1, J4.4
P3.3V: FB1.2, R28.1, R40.1, R41.1, R42.1, R43.1; also elsewhere on the board
SD0_CD: J4.9, R28.2; also elsewhere on the board
SD0_CLK: J4.5; also elsewhere on the board
SD0_CMD: J4.3, R42.2; also elsewhere on the board
SD0_DAT0: J4.7, R41.2; also elsewhere on the board
SD0_DAT1: J4.8, R40.2; also elsewhere on the board
SD0_DAT2: J4.1, R43.2; also elsewhere on the board
SD0_DAT3: J4.2; also elsewhere on the board

Notes on the sheet:
DAT2 DAT3/CD CMD VDD CLK VSS DAT0 DAT1 DET

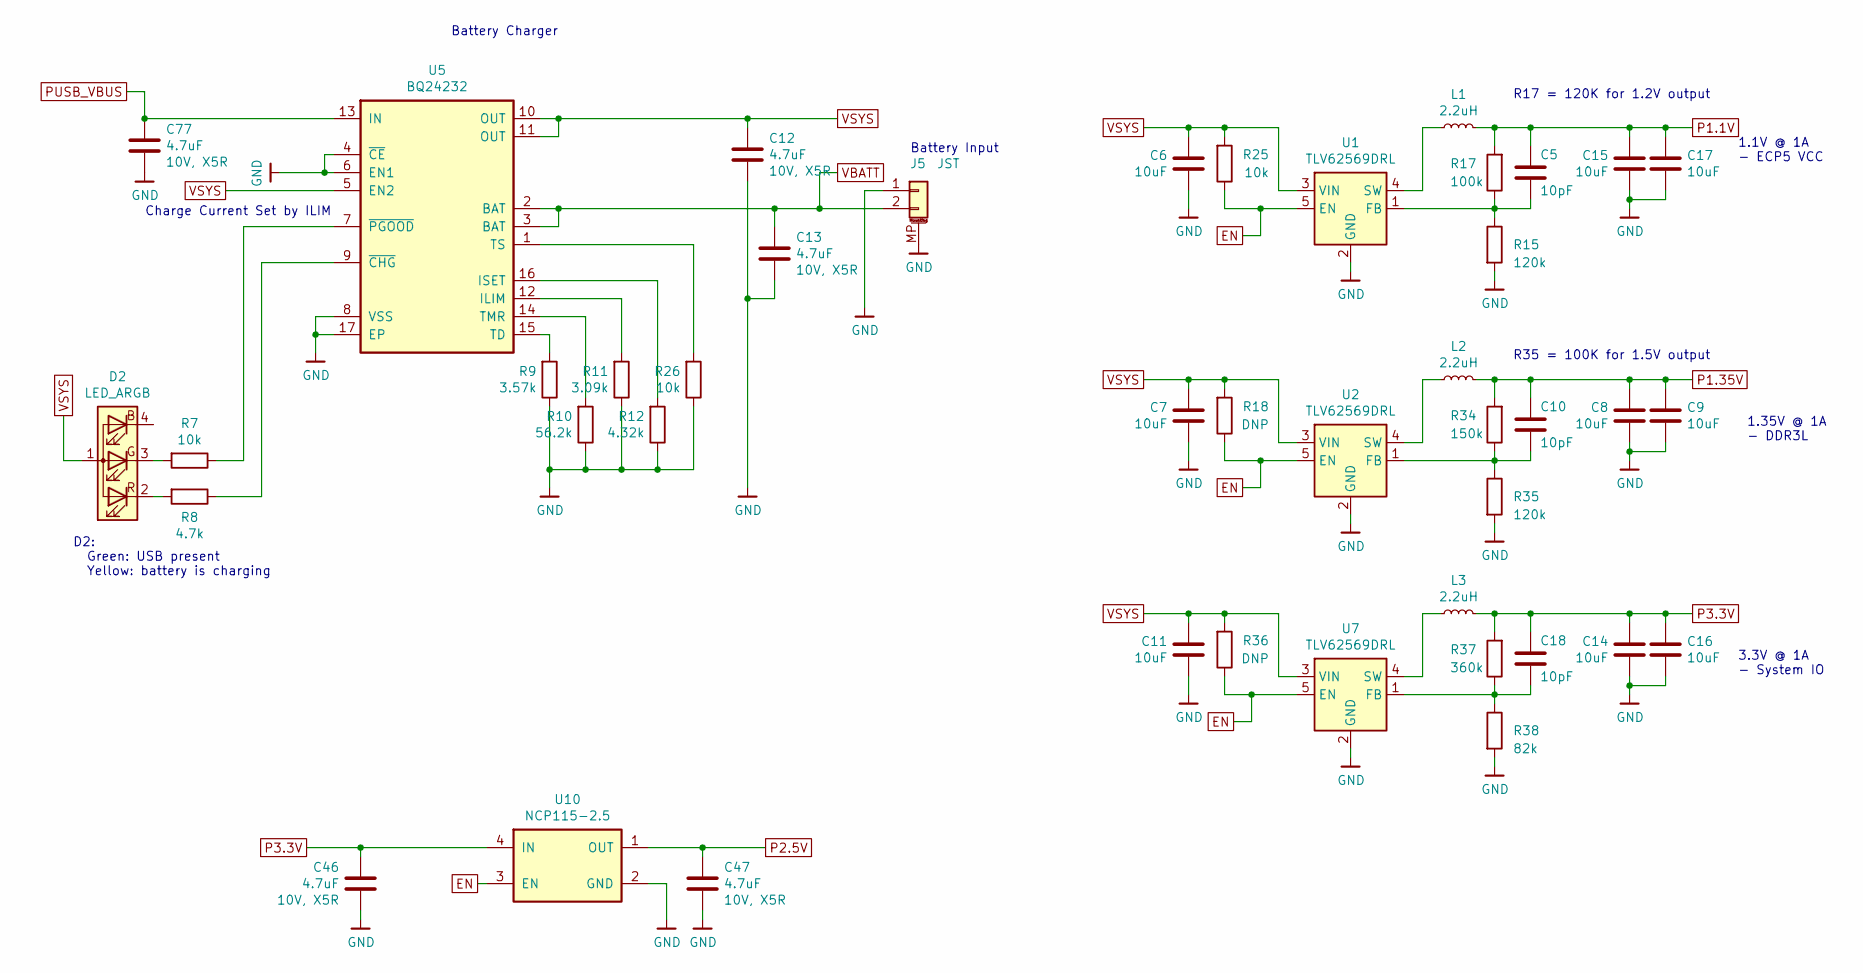
[picture p13: schematic POWER.kicad_sch, Orange Crab]

Parts:
C5, C10, C18: 10pF; C_0201_0603Metric
C6, C7, C8, C9, C11, C14, C15, C16, C17: 10uF; C_0402_1005Metric
C12, C13, C46, C47, C77: 4.7uF; C_0402_1005Metric
D2: LED_ARGB; 0404LED_RGB
J5: JST; JST_PH_B2B-PH-SM4-TB_1x02-1MP_P2.00mm_Vertical
L1, L2, L3: 2.2uH; L_0805_2012Metric
R7, R25, R26: 10k; R_0201_0603Metric
R8: 4.7k; R_0201_0603Metric
R9: 3.57k; R_0201_0603Metric
R10: 56.2k; R_0201_0603Metric
R11: 3.09k; R_0201_0603Metric
R12: 4.32k; R_0201_0603Metric
R15, R35: 120k; R_0201_0603Metric
R17: 100k; R_0201_0603Metric
R18, R36: DNP; R_0201_0603Metric
R34: 150k; R_0201_0603Metric
R37: 360k; R_0201_0603Metric
R38: 82k; R_0201_0603Metric
U1, U2, U7: TLV62569DRL; SOT-563
U5: BQ24232; QFN-16-1EP_3x3mm_P0.5mm_EP1.75x1.75mm
U10: NCP115-2.5; Texas_X2SON-4_1x1mm_P0.65mm

Connections:
EN: R18.1, R25.1, R36.1, U1.5 (EN), U2.5 (EN), U7.5 (EN), U10.3 (EN); also elsewhere on the board
GND: C6.1, C7.1, C8.1, C9.1, C11.1, C12.2, C13.2, C14.1, C15.1, C16.1, C17.1, C46.2, C47.2, C77.2, J5.1, J5.MP (MountPin), R9.1, R10.1, R11.1, R12.1, R15.2, R26.1, R35.2, R38.2, U1.2 (GND), U2.2 (GND), U5.4 (~CE), U5.6 (EN1), U5.8 (VSS), U5.17 (EP), U7.2 (GND), U10.2 (GND); also elsewhere on the board
unnamed: D2.3 (GK), R7.2
unnamed: D2.2 (RK), R8.2
unnamed: C5.1, R15.1, R17.1, U1.1 (FB)
unnamed: L1.1, U1.4 (SW)
unnamed: C10.1, R34.1, R35.1, U2.1 (FB)
unnamed: L2.1, U2.4 (SW)
unnamed: R11.2, U5.12 (ILIM)
unnamed: R12.2, U5.16 (ISET)
unnamed: R9.2, U5.15 (TD)
unnamed: R10.2, U5.14 (TMR)
unnamed: R26.2, U5.1 (TS)
unnamed: R8.1, U5.9 (~CHG)
unnamed: R7.1, U5.7 (~PGOOD)
unnamed: C18.1, R37.1, R38.1, U7.1 (FB)
unnamed: L3.1, U7.4 (SW)
P1.1V: C5.2, C15.2, C17.2, L1.2, R17.2; also elsewhere on the board
P1.35V: C8.2, C9.2, C10.2, L2.2, R34.2; also elsewhere on the board
P2.5V: C47.1, U10.1 (OUT); also elsewhere on the board
P3.3V: C14.2, C16.2, C18.2, C46.1, L3.2, R37.2, U10.4 (IN); also elsewhere on the board
PUSB_VBUS: C77.1, U5.13 (IN); also elsewhere on the board
VBATT: C13.1, J5.2, U5.2 (BAT), U5.3 (BAT); also elsewhere on the board
VSYS: C6.2, C7.2, C11.2, C12.1, D2.1 (A), R18.2, R25.2, R36.2, U1.3 (VIN), U2.3 (VIN), U5.5 (EN2), U5.10 (OUT), U5.11 (OUT), U7.3 (VIN)

Notes on the sheet:
R35 = 100K for 1.5V output
1.35V @ 1A - DDR3L
Charge Current Set by ILIM
3.3V @ 1A - System IO
Battery Charger
R17 = 120K for 1.2V output
1.1V @ 1A - ECP5 VCC
Battery Input
D2: Green: USB present Yellow: battery is charging

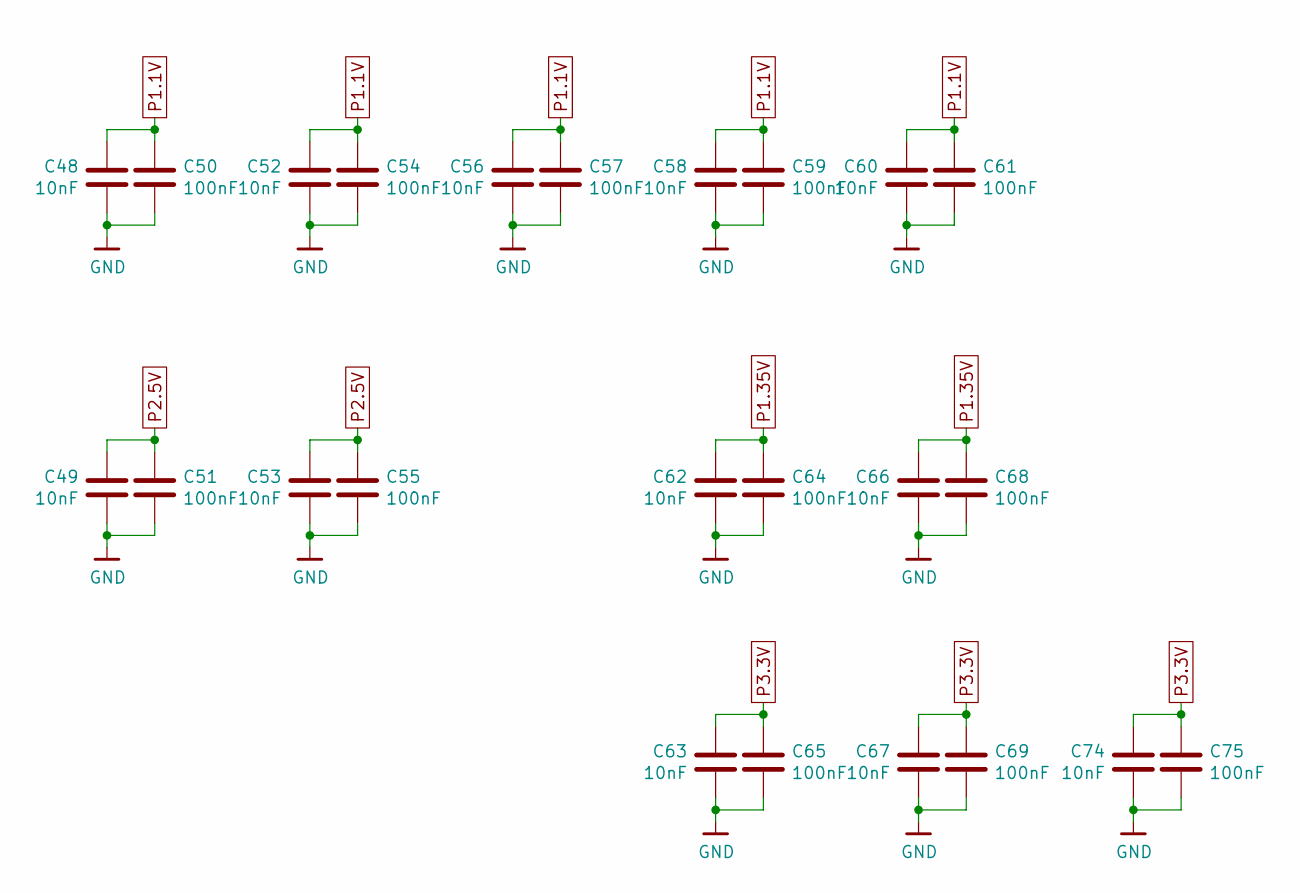
[picture p14: schematic DECOUPLING.kicad_sch, Orange Crab]

Parts:
C48, C49, C52, C53, C56, C58, C60, C62, C63, C66, C67, C74: 10nF; C_0201_0603Metric
C50, C51, C54, C55, C57, C59, C61, C64, C65, C68, C69, C75: 100nF; C_0201_0603Metric

Connections:
GND: C48.2, C49.2, C50.2, C51.2, C52.2, C53.2, C54.2, C55.2, C56.2, C57.2, C58.2, C59.2, C60.2, C61.2, C62.2, C63.2, C64.2, C65.2, C66.2, C67.2, C68.2, C69.2, C74.2, C75.2; also elsewhere on the board
P1.1V: C48.1, C50.1, C52.1, C54.1, C56.1, C57.1, C58.1, C59.1, C60.1, C61.1; also elsewhere on the board
P1.35V: C62.1, C64.1, C66.1, C68.1; also elsewhere on the board
P2.5V: C49.1, C51.1, C53.1, C55.1; also elsewhere on the board
P3.3V: C63.1, C65.1, C67.1, C69.1, C74.1, C75.1; also elsewhere on the board
