w531t4/orangecrab-hardware/hardware/altcrab_r0.0.1/OrangeCrab.kicad_pcb

## KiCad design hardware/altcrab_r0.0.1/OrangeCrab.kicad_pcb (continued)

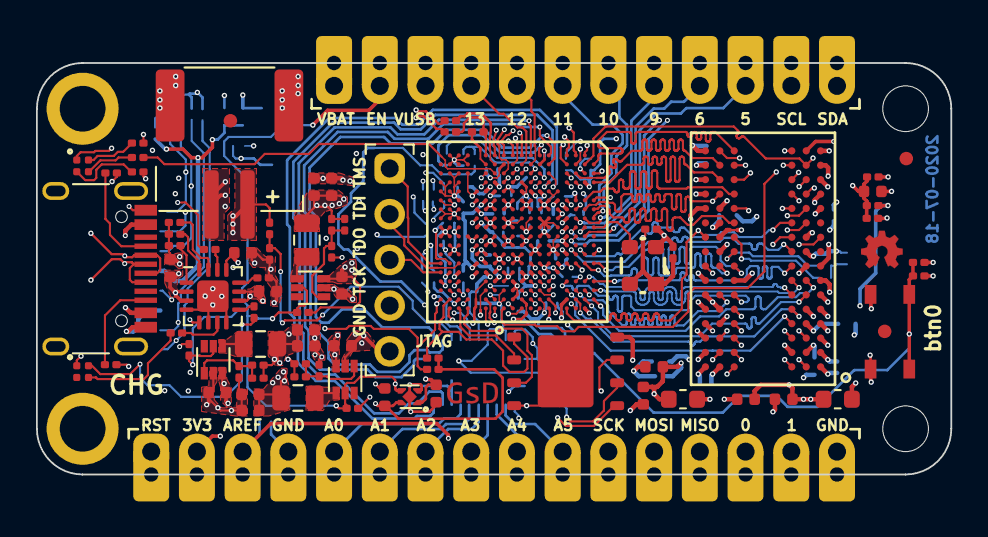
[picture p15: board OrangeCrab.kicad_pcb from above]

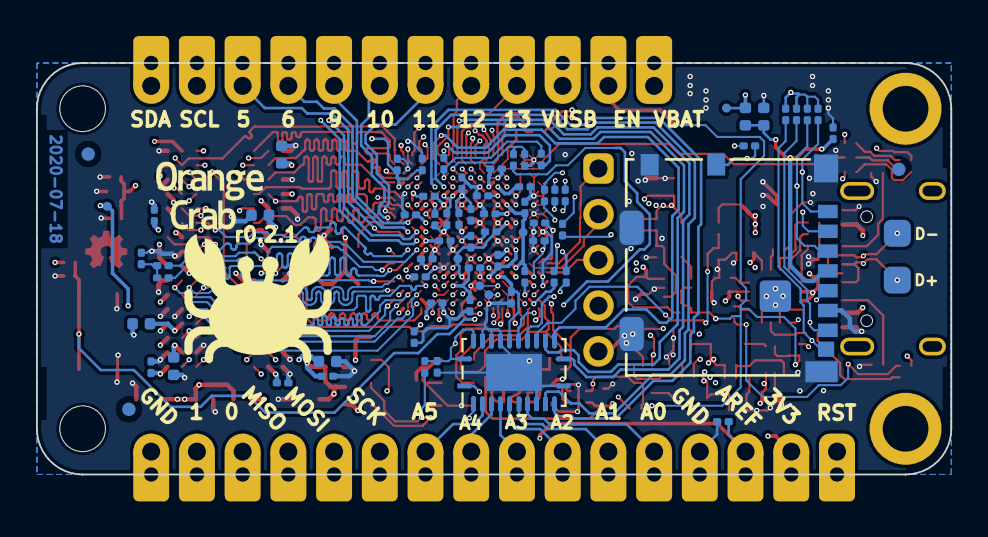
[picture p16: board OrangeCrab.kicad_pcb from below]

Board: 6 copper layers, 50.8 x 22.9 mm, 160 parts (74 on the bottom side), 152 nets.
