w531t4/orangecrab-hardware/(commit log)

2026-04-30 kicad 9 upgrade
    [DECOUPLING.kicad_sch, DRAM.kicad_sch, FPGA.kicad_sch, IO.kicad_sch, OrangeCrab.kicad_pcb, OrangeCrab.kicad_sch, POWER.kicad_sch, SDMMC.kicad_sch]
2026-04-30 fix: KiCad 9's migration appended unit suffixes to schematic references (U3→U3A…U3I), mismatching the PCB's bare U3.
    [FPGA.kicad_sch]
2026-04-30 after update from schematic
    [OrangeCrab.kicad_pcb]
2026-04-30 remove kicad v5 files
    [DECOUPLING.sch, DRAM.sch, FPGA.sch, IO.sch, OrangeCrab.sch, POWER.sch, SDMMC.sch, decopling.sch]
2026-04-30 update project footprint table
2026-04-30 chore: remove stale cross-sheet instance paths from KiCad 9 migration
    [DRAM.kicad_sch, FPGA.kicad_sch, IO.kicad_sch, SDMMC.kicad_sch]
2026-04-30 update footprint in schematic for feather pins
    [IO.kicad_sch]
2026-04-30 update pcb from schematic after footprint changes
    [OrangeCrab.kicad_pcb]
